dfannin/gpsdo/gpsdo-pll-v4.png

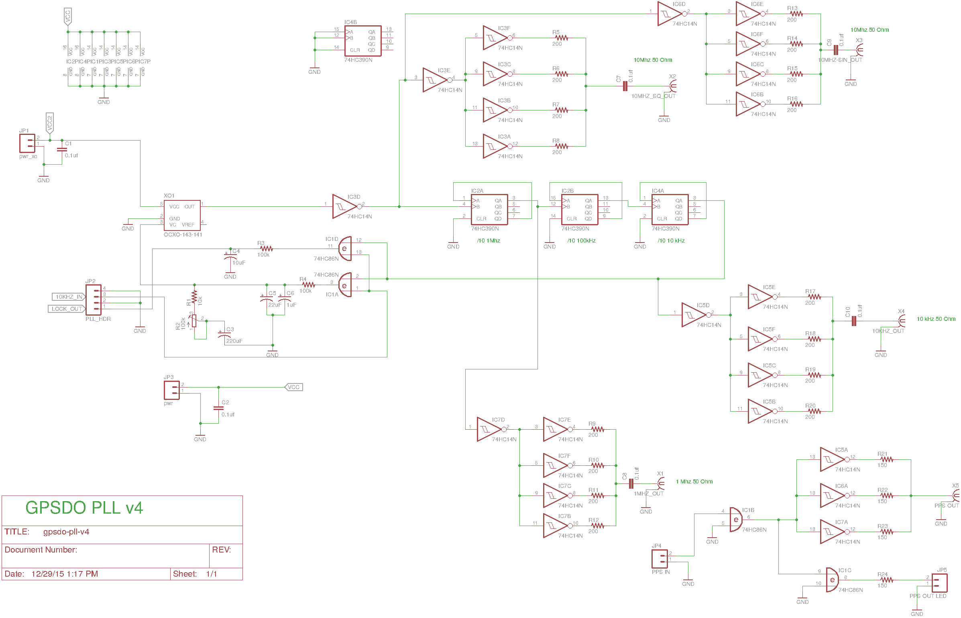
gpsdo-pll-v4.png
