dfannin/gpsdo/img/GPSDOBlockDiagram.jpg

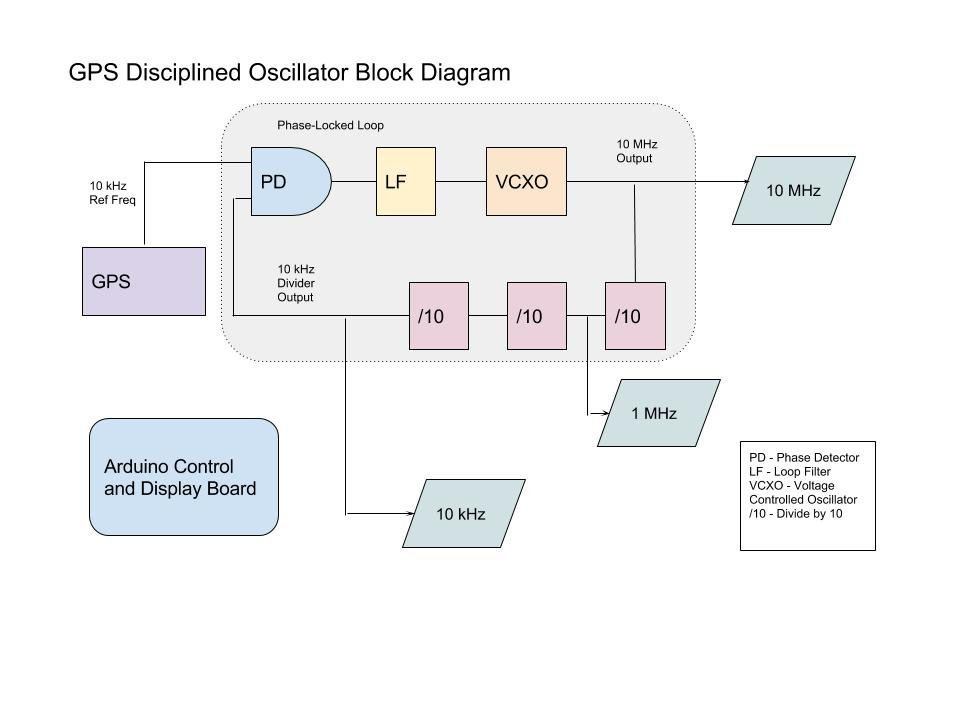
img/GPSDOBlockDiagram.jpg
